JeppeSRC/Stepper-Driver/documentation/specification.txt

Targeted specs: (not finalized)
    Stepper Type:   2 Phase Bipolar
    Input Voltage:  5-15V
    Phase current:  0.5-5A

Components: (preliminary)
    3V3 LDO: AP7370-33SA-7 (https://www.mouser.se/datasheet/2/115/AP7370-1605740.pdf)
    N FET: DMG4496SSS (https://www.mouser.se/datasheet/2/115/ds32048-88618.pdf)
    P FET: FDS4435BZ (https://www.mouser.se/datasheet/2/308/FDS4435BZ-1295162.pdf)
    FET Driver: FAN3278TMX (https://www.mouser.se/datasheet/2/308/FAN3278-1300254.pdf)
    Current Sense Amp: MCP6L02T-E/SN (https://www.mouser.se/datasheet/2/268/22140a-71218.pdf)
    Controller MCU: STM32F303K
        - Datasheet: https://www.st.com/resource/en/datasheet/stm32f303k6.pdf
        - Reference Manual: https://www.st.com/content/ccc/resource/technical/document/reference_manual/4a/19/6e/18/9d/92/43/32/DM00043574.pdf/files/DM00043574.pdf/jcr:content/translations/en.D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
