JeppeSRC/Stepper-Driver/kicad/StepperDriver.csv

MPN | Quantity
EKZN500ELL101MHB5D | 4
CC0805KRX7R9BB104 | 5
TMK212B7105KG-T | 7
CC0805KRX7R0BB103 | 2
ESY337M025AG8AA | 2
TMK212BBJ106MGHT | 5
GRM21BR71C475KE51L | 1
B540C-13-F | 8
SMAJ16A | 1
20020327-C021B01LF | 1
20020327-C021B01LF | 1
20020327-C021B01LF | 1
CRCW080510K0FKEAC | 13
RT0805FRE071KL | 13
CRGCQ0805F100K | 2
CR0805-FX-7151ELF | 2
ESR10EZPJ1R0 | 20
LL3301NF065QG | 1
AP7370-33SA-7 | 1
FAN3278TMX | 4
MCP6L02T-E/SN | 1
STM32F303K6T6 | 1
FDS4435BZ | 4
DMG4496SSS-13 | 4
