JeppeSRC/Stepper-Driver/kicad/StepperDriver.kicad_pcb

## KiCad design kicad/StepperDriver.kicad_pcb (2019-10-12)

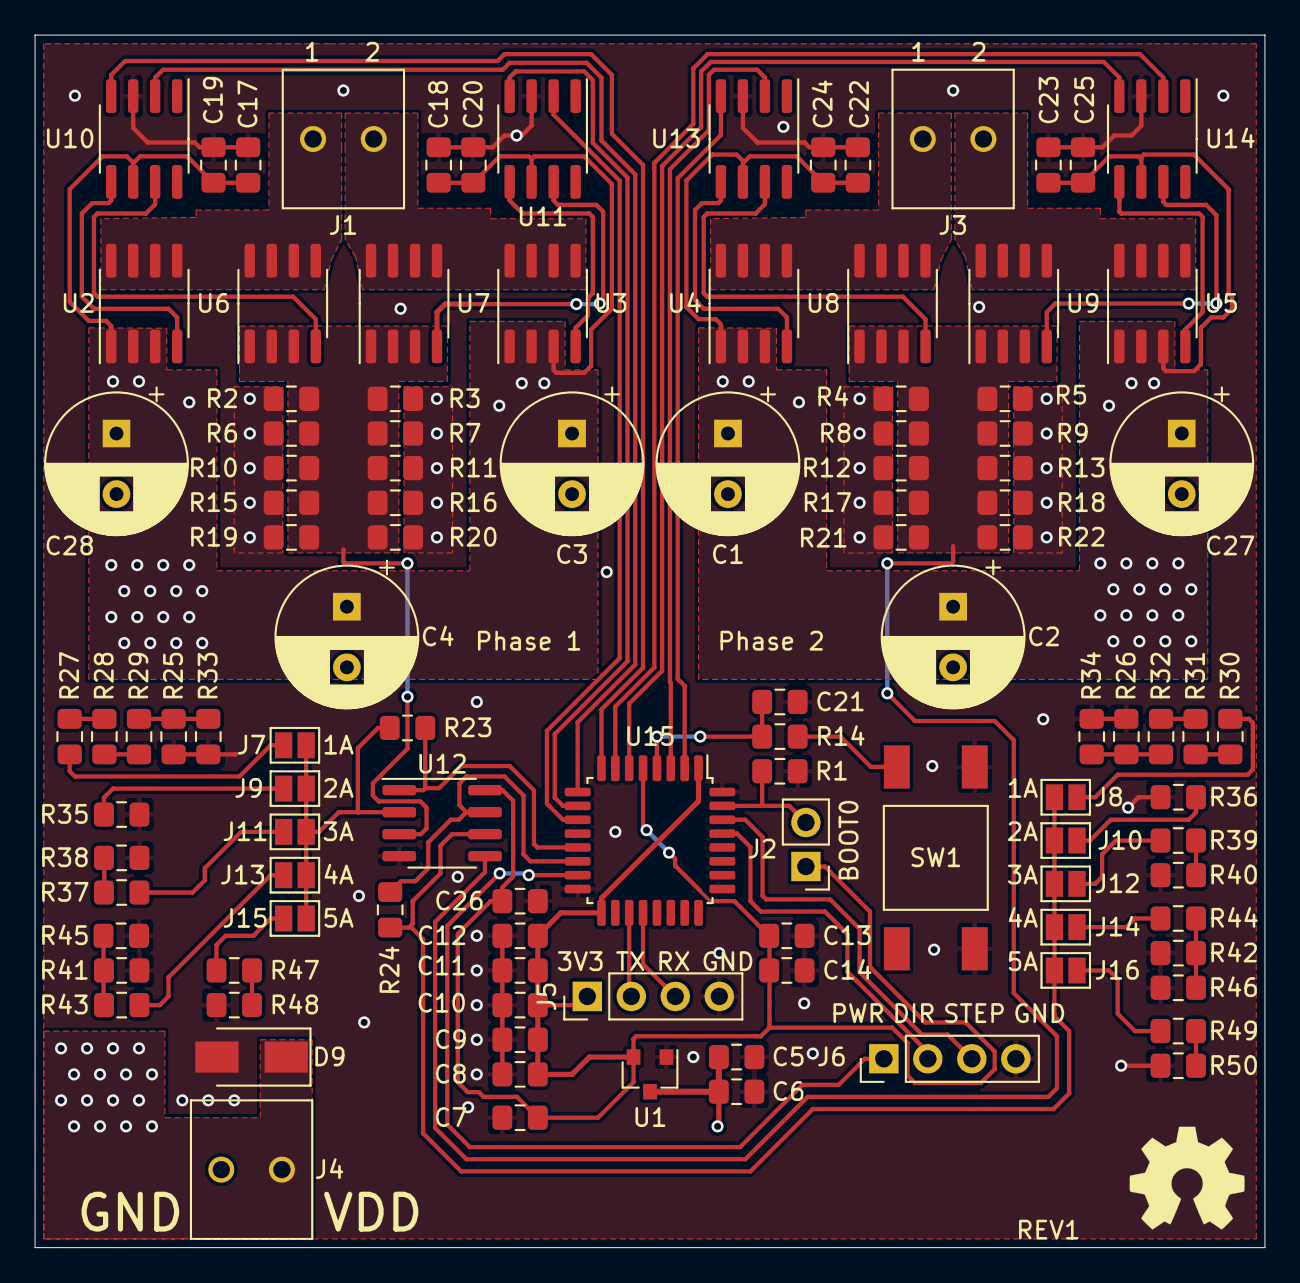
[picture p1: board StepperDriver.kicad_pcb from above]

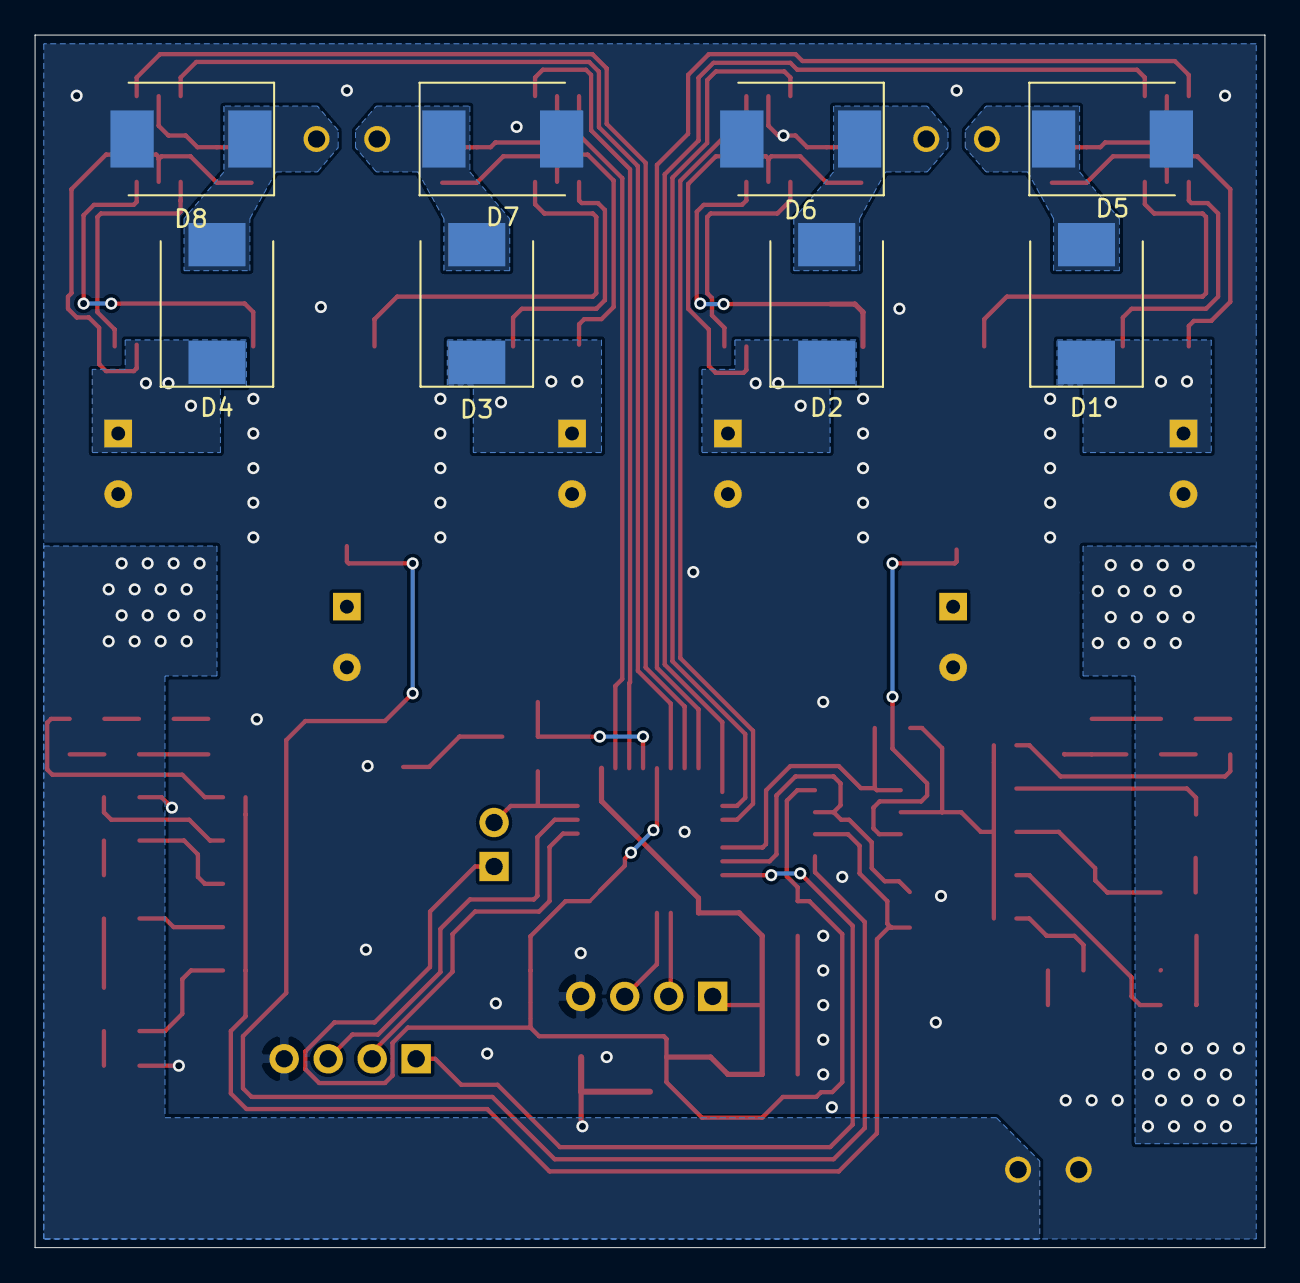
[picture p2: board StepperDriver.kicad_pcb from below]

Board: 2 copper layers, 71.0 x 70.0 mm, 119 parts (8 on the bottom side), 61 nets.

Parts:
C1, C3, C27, C28: 100µF; CP_Radial_D8.0mm_P3.50mm
C2, C4: 330µF; CP_Radial_D8.0mm_P3.50mm
C5, C17, C18, C22, C23: 10µF; C_0805_2012Metric_Pad1.15x1.40mm_HandSolder
C6, C7, C13, C19, C20, C24, C25: 1µF; C_0805_2012Metric_Pad1.15x1.40mm_HandSolder
C8: 4.7µF; C_0805_2012Metric_Pad1.15x1.40mm_HandSolder
C9, C10, C11, C12, C26: 100nF; C_0805_2012Metric_Pad1.15x1.40mm_HandSolder
C14, C21: 10nF; C_0805_2012Metric_Pad1.15x1.40mm_HandSolder
D1, D2, D3, D4, D5, D6, D7, D8: B540C; D_SMC
D9: SMAJ16A; D_SMA
J1: Phase 1; 20020327-C02xB0xLF
J2: BOOT0; PinHeader_1x02_P2.54mm_Vertical
J3: Phase 2; 20020327-C02xB0xLF
J4: Power In; 20020327-C02xB0xLF
J5: USART; PinHeader_1x04_P2.54mm_Vertical
J6: Control IO; PinHeader_1x04_P2.54mm_Vertical
J7, J8: 1A; SolderJumper-2_P1.3mm_Open_Pad1.0x1.5mm
J9, J10: 2A; SolderJumper-2_P1.3mm_Open_Pad1.0x1.5mm
J11, J12: 3A; SolderJumper-2_P1.3mm_Open_Pad1.0x1.5mm
J13, J14: 4A; SolderJumper-2_P1.3mm_Open_Pad1.0x1.5mm
J15, J16: 5A; SolderJumper-2_P1.3mm_Open_Pad1.0x1.5mm
NT1, NT2: NT; NetTie-2_SMD_Pad0.5mm
R1, R37, R39, R41, R42, R43, R44, R45, R46, R47, R48, R49, R50: 10k; R_0805_2012Metric_Pad1.15x1.40mm_HandSolder
R2, R3, R4, R5, R6, R7, R8, R9, R10, R11, R12, R13, R15, R16, R17, R18, R19, R20, R21, R22: 1R; R_0805_2012Metric_Pad1.15x1.40mm_HandSolder
R14, R25, R26, R27, R28, R29, R30, R31, R32, R33, R34, R38, R40: 1k; R_0805_2012Metric_Pad1.15x1.40mm_HandSolder
R23, R24: 100k; R_0805_2012Metric_Pad1.15x1.40mm_HandSolder
R35, R36: 7k15; R_0805_2012Metric_Pad1.15x1.40mm_HandSolder
SW1: Reset; LL3301NF065QG
U1: AP7370; SOT-23
U2, U3, U4, U5: FDS4435BZ; SOIC-8_3.9x4.9mm_P1.27mm
U6, U7, U8, U9: DMG4496SSS; SOIC-8_3.9x4.9mm_P1.27mm
U10, U11, U13, U14: FAN3278; SOIC-8_3.9x4.9mm_P1.27mm
U12: MCP6L02; SOIC-8_3.9x4.9mm_P1.27mm
U15: STM32F303K6Tx; LQFP-32_7x7mm_P0.8mm

Connections:
+3V3: C7.1, C26.2, J2.1, NT1.1, NT2.1, U1.2, U12.8
/BOOT0: J2.2, R1.1, U15.31
/CurrentSelection/P1_GAIN: J7.1, J9.1, J11.1, J13.1, J15.1, R23.2, U12.2
/CurrentSelection/P2_GAIN: J8.1, J10.1, J12.1, J14.1, J16.1, R24.1, U12.6
/IN_DIR: J6.2, U15.29
/IN_PWR: J6.1, U15.15
/IN_STEP: J6.3, U15.30
/IP1: R23.1, U12.1, U15.13
/IP2: R24.2, U12.7, U15.14
/P1.1: D1.2, D5.1, J1.2, U2.5, U2.6, U2.7, U2.8, U6.5, U6.6, U6.7, U6.8
/P1.2: D2.2, D6.1, J1.1, U3.5, U3.6, U3.7, U3.8, U7.5, U7.6, U7.7, U7.8
/P1_1: U10.4, U15.8
/P1_2: U10.2, U15.9
/P1_3: U11.4, U15.10
/P1_4: U11.2, U15.11
/P1_FET1: U2.4, U10.5
/P1_FET2: U6.4, U10.7
/P1_FET3: U3.4, U11.5
/P1_FET4: U7.4, U11.7
/P1_SENSE: R2.2, R3.1, R6.2, R7.1, R10.2, R11.1, R15.2, R16.1, R19.2, R20.1, U6.1, U6.2, U6.3, U7.1, U7.2, U7.3, U12.3
/P2.1: D3.2, D7.1, J3.2, U4.5, U4.6, U4.7, U4.8, U8.5, U8.6, U8.7, U8.8
/P2.2: D4.2, D8.1, J3.1, U5.5, U5.6, U5.7, U5.8, U9.5, U9.6, U9.7, U9.8
/P2_1: U13.4, U15.2
/P2_2: U13.2, U15.3
/P2_3: U14.4, U15.6
/P2_4: U14.2, U15.7
/P2_FET1: U4.4, U13.5
/P2_FET2: U8.4, U13.7
/P2_FET3: U5.4, U14.5
/P2_FET4: U9.4, U14.7
/P2_SENSE: R4.2, R5.1, R8.2, R9.1, R12.2, R13.1, R17.2, R18.1, R21.2, R22.1, U8.1, U8.2, U8.3, U9.1, U9.2, U9.3, U12.5
/RST: C21.2, R14.1, U15.4
/USART_RX: J5.3, U15.20
/USART_TX: J5.2, U15.19
/VDD1: C8.1, C9.1, C10.1, C11.1, C12.1, J5.1, NT1.2, U15.1, U15.17
/VDDA: C13.1, C14.1, NT2.2, U15.5
GND: C1.2, C2.2, C3.2, C4.2, C5.2, C6.1, C7.2, C8.2, C9.2, C10.2, C11.2, C12.2, C13.2, C14.2, C17.2, C18.2, C19.2, C20.2, C21.1, C22.2, C23.2, C24.2, C25.2, C26.1, C27.2, C28.2, D5.2, D6.2, D7.2, D8.2, D9.2, J4.1, J5.4, J6.4, R1.2, R2.1, R3.2, R4.1, R5.2, R6.1, R7.2, R8.1, R9.2, R10.1, R11.2, R12.1, R13.2, R15.1, R16.2, R17.1, R18.2, R19.1, R20.2, R21.1, R22.2, R25.1, R26.1, R33.1, R34.1, R35.1, R36.1, R38.1, R40.1, R41.1, R42.1, R45.1, R46.1, R48.1, R50.1, SW1.1, U1.1, U10.3, U11.3, U12.4, U13.3, U14.3, U15.16, U15.32
unnamed: J7.2, R27.2
unnamed: J8.2, R30.2
unnamed: J9.2, R35.2
unnamed: J10.2, R36.2
unnamed: J11.2, R37.2
unnamed: J12.2, R39.2
unnamed: J13.2, R43.2
unnamed: J14.2, R44.2
unnamed: J15.2, R47.2
unnamed: J16.2, R49.2
unnamed: R14.2, SW1.2
unnamed: R25.2, R29.1, R33.2
unnamed: R26.2, R32.1, R34.2
unnamed: R27.1, R28.2
unnamed: R28.1, R29.2
unnamed: R30.1, R31.2
unnamed: R31.1, R32.2
unnamed: R37.1, R38.2
unnamed: R39.1, R40.2
unnamed: R41.2, R43.1, R45.2
unnamed: R42.2, R44.1, R46.2
unnamed: R47.1, R48.2
unnamed: R49.1, R50.2
VDD: C1.1, C2.1, C3.1, C4.1, C5.1, C6.2, C17.1, C18.1, C19.1, C20.1, C22.1, C23.1, C24.1, C25.1, C27.1, C28.1, D1.1, D2.1, D3.1, D4.1, D9.1, J4.2, U1.3, U2.1, U2.2, U2.3, U3.1, U3.2, U3.3, U4.1, U4.2, U4.3, U5.1, U5.2, U5.3, U10.6, U11.6, U13.6, U14.6
