JeppeSRC/Stepper-Driver/documentation/operation.txt

Connectors
    J4: Power input
    J1: Motor phase 1
    J3: Motor phase 2
    J5: Programming
    J6: Motor control
