JeppeSRC/Stepper-Driver/firmware/src/peripherals/addresses.h

#pragma once

#define GPIOF 0x48001400
#define GPIOD 0x48000C00
#define GPIOC 0x48000800
#define GPIOB 0x48000400
#define GPIOA 0x48000000

#define RCC 0x40021000

#define SYSCFG 0x40010000
#define COMP SYSCFG

#define DAC1 0x40007400
#define DAC2 0x40009800

#define ADC1 0x50000000

#define EXTI 0x40010400

#define SCB 0xE000E000

#define TIM1 0x40012C00
#define TIM2 0x40000000
#define TIM3 0x40000400
#define TIM6 0x40001000
#define TIM7 0x40001400
#define TIM15 0x40014000
#define TIM16 0x40014400
#define TIM17 0x40014800
