JeppeSRC/Stepper-Driver/(commit log)

2018-09-08 Pin setup
2018-09-30 PCB Gerber files
2019-09-14 Added kicad projecty
    [StepperDriver.kicad_pcb, StepperDriver.sch]
2019-09-15 Changed symbols to the new parts and added matching footprint
2019-09-15 H Bridge
    [H-Bridge.sch]
2019-09-16 Chagned MCU to STM32F303K
2019-09-16 Some mcu connections
    [StepperDriver.sch]
2019-09-16 Fixed serious flaw
    [H-Bridge.sch]
2019-09-16 Flipped p channel driver amps to make a positive input turn on the fet
    [H-Bridge.sch]
2019-09-17 Added sqaure thing around each H bridge
    [H-Bridge.sch, StepperDriver.sch]
2019-09-18 Added 3V3 regulator
    [StepperDriver.sch]
2019-09-20 Fixed incorrect symbol
    [H-Bridge.sch]
2019-09-20 Back down voltage spec
2019-09-20 Replaced OpAmp with descrete MOSFET and pullups
    [H-Bridge.sch]
2019-09-20 Added 10 resistors in paralell for the current shunt
    [H-Bridge.sch]
2019-09-20 increased one cap to 1mF
    [H-Bridge.sch]
2019-09-20 Aded STM32F303 datasheets
2019-09-20 Added MCU decoupeling caps
    [StepperDriver.sch]
2019-09-20 Forgot one ground symbol lol
    [StepperDriver.sch]
2019-09-21 Added some connectors
    [StepperDriver.sch]
2019-09-22 Updated fet driver to gate driver IC
2019-09-22 Removed Vin on sheet and moved pins so I could make the hierarchical sheet smaller
    [StepperDriver.sch]
2019-09-22 Redesigned H bridge to use FAN3278
    [H-Bridge.sch]
2019-09-23 Removed annotation
    [H-Bridge.sch, StepperDriver.sch]
2019-09-23 Added caps to 3v3 regulator
    [StepperDriver.sch]
2019-09-23 Re org
    [H-Bridge.sch, StepperDriver.sch]
2019-09-23 Added page info
    [StepperDriver.sch]
2019-09-23 Moved shit to make it look more symetrical
    [StepperDriver.sch]
2019-09-23 Added no connects to unused MCU pins
    [StepperDriver.sch]
2019-09-23 Changed H bridge block description
    [StepperDriver.sch]
2019-09-23 Minor change
    [StepperDriver.sch]
2019-09-23 Assigned footprint to all MLCC caps
    [StepperDriver.sch]
2019-09-23 Corrected some 100µF caps that were unpolarized and change them to be polarized
    [StepperDriver.sch]
2019-09-23 JK forgot some MLCC caps
    [StepperDriver.sch]
2019-09-23 Footprints for 100µF caps
    [StepperDriver.sch]
2019-09-23 1000µF cap footprints
    [StepperDriver.sch]
2019-09-23 Swicth footprint
2019-09-26 Transient snubber
    [StepperDriver.sch]
2019-09-26 Changed values of shunt resistors to 2R instead of 0R2
    [StepperDriver.sch]
2019-09-26 Rewired digi pot to not make values inverted
    [StepperDriver.sch]
2019-09-27 Added mpn to Ux symbols
    [StepperDriver.sch]
2019-09-27 Added 1000µF MPN
    [StepperDriver.sch]
2019-09-27 Added 100µF MPN
    [StepperDriver.sch]
2019-09-27 Added 10µF MPN
    [StepperDriver.sch]
2019-09-27 Added 4.7µF MPN
    [StepperDriver.sch]
2019-09-27 Added 1µF MPN
    [StepperDriver.sch]
2019-09-27 Added 100nF MPN
    [StepperDriver.sch]
2019-09-27 Added 10nF MPN
    [StepperDriver.sch]
2019-09-28 Flyback diodes MPN and footprint
    [StepperDriver.sch]
2019-09-28 Bunch of datasheets and shit
    [StepperDriver.sch]
2019-09-28 Power in connector footprint and MPN
    [StepperDriver.sch]
2019-09-28 Split motor connector to one connector per phase
    [StepperDriver.sch]
2019-09-28 Changed Power in symbol to scren terminal
    [StepperDriver.sch]
2019-09-28 Screw terminal footprint, datasheet and mpn
    [StepperDriver.sch]
2019-09-28 More mpn stuff
    [StepperDriver.sch]
2019-09-29 Fixed unreadable stuff
    [StepperDriver.sch]
2019-09-29 Fixed unreadable stuff 2
    [StepperDriver.sch]
2019-09-29 Removed weird wire
    [StepperDriver.sch]
2019-09-29 Control IO and fixed some ERC errors
    [StepperDriver.sch]
2019-09-29 Removed MCP4251 and added jumpers for current selection
    [CurrentSelection.sch, StepperDriver.sch]
2019-10-01 Changed current shunt to 0.1Ohm
    [CurrentSelection.sch, StepperDriver.sch]
2019-10-01 Current selection through solder bridges
    [CurrentSelection.sch]
2019-10-01 Changed LD1086 to AP7370
    [StepperDriver.sch]
2019-10-01 Minimum requirements
    [StepperDriver.kicad_pcb]
2019-10-01 Removed Resistor in series with TVS diode
    [StepperDriver.sch]
2019-10-01 Changed diode footprints
    [CurrentSelection.sch, StepperDriver.kicad_pcb, StepperDriver.sch]
2019-10-01 Updated symbols
    [StepperDriver.sch]
2019-10-02 Swapped some pins on FET drivers
    [StepperDriver.sch]
2019-10-02 Some kind of beginning of layout
    [StepperDriver.kicad_pcb]
2019-10-03 Digital ground for micro
    [StepperDriver.sch]
2019-10-03 Changed bypassing on gate drivers
    [CurrentSelection.sch, StepperDriver.sch]
2019-10-03 Some other form of layout
    [StepperDriver.kicad_pcb]
2019-10-03 Fixed zone net
    [StepperDriver.kicad_pcb]
2019-10-03 Grid settings
    [StepperDriver.kicad_pcb]
2019-10-03 Changed min via size stuff
    [StepperDriver.kicad_pcb]
2019-10-05 Sense resistors tied to ground
    [StepperDriver.kicad_pcb]
2019-10-08 Changed 100µF caps to ones with higher ripple current
    [StepperDriver.sch]
2019-10-08 Changed 1000µF caps to 330µF caps with higher ripple current
    [StepperDriver.sch]
2019-10-08 Layout stuff
    [StepperDriver.kicad_pcb]
2019-10-08 Some power planes
    [StepperDriver.kicad_pcb]
2019-10-09 Removed 10µF caps on h bridge
    [StepperDriver.sch]
2019-10-10 Fixed failöed wiring
    [StepperDriver.sch]
2019-10-10 Routed Gate driver signals
    [StepperDriver.kicad_pcb, StepperDriver.sch]
2019-10-11 Fixed schematic error
    [StepperDriver.sch]
2019-10-11 Removed digital ground
    [StepperDriver.sch]
2019-10-11 Changed input pinout
    [StepperDriver.sch]
2019-10-11 Layout pretty much done
    [StepperDriver.kicad_pcb]
2019-10-11 Removed thing
    [StepperDriver.sch]
2019-10-12 Minor changes
    [StepperDriver.kicad_pcb]
2019-10-12 Added Dwgs.User layer
    [StepperDriver.kicad_pcb]
2019-10-12 Added layer outline to Dwgs.User layer for easier panelization
    [StepperDriver.kicad_pcb]
2019-10-12 Added silkscreen stuff
    [StepperDriver.kicad_pcb]
2019-10-12 Fixed FAN3278 datasheet
    [StepperDriver.sch]
2019-10-12 Moved some traces
    [StepperDriver.kicad_pcb]
2019-10-12 Added thermal relief to low power pins
    [StepperDriver.kicad_pcb]
2019-10-19 Exported BOM
    [StepperDriver.csv]
2019-10-19 Changed cap
    [StepperDriver.csv, StepperDriver.sch]
2020-02-16 Workaround to prevent lto from removing interrupt handlers. GCC is a peice of shit
2020-02-20 This might make the motor spin
2020-02-27 Changed what happens when current limit is reached
